abouzk/esp32-weld-motion-controller/README.md

# Automated Welding Workcell - Electromechanical Subsystem (Capstone)

**Role:** Electromechanical Subsystem Lead | **Platform:** ESP32 DevKit + DM542T Stepper Driver | **Actuator:** NEMA 23 (10:1 Gearbox) + Belt Drive Linear Actuator

**Context:** Senior Capstone Project — Automated Welding Theory Lab for undergraduate welding education at RPI.

---

## 1. Project Overview

This repository contains the embedded motion control firmware and electromechanical system architecture for an **automated weld travel system** that delivers consistent, repeatable weld beads for undergraduate metallurgical analysis.

The system replaces manual hand-welding (which introduces uncontrolled human variability in travel speed) with a deterministic linear actuator system, enabling students to isolate and study weld metallurgy rather than weld technique. My scope covers the electromechanical subsystem: drive analysis, speed derivation, microstepping configuration, state machine design, and motion control firmware.

Weld samples produced by the system undergo multi-stage analysis at the RPI Materials Research Center (MRC): macroetching, optical microscopy, and fillet weld break testing.

> **Full design rationale, trade studies, and speed derivations:** [Engineering Notebook Welding Log](https://github.com/abouzk/systems-engineering-notebook/blob/main/logs/esp32-weld-motion-controller-log.md)

---

## 2. Concept of Operations

The electromechanical subsystem occupies the **weld execution phase** of the broader lab workflow. From the operator's perspective:

```mermaid
flowchart LR
    A([Operator\nsets parameters]) --> B[System\nhomes to zero]
    B --> C[READY\nfor weld]
    C --> D[Operator\nstrikes arc]
    D --> E[Controlled travel\nat 6–8 IPM]
    E --> F[Target distance\nreached — HOLD]
    F --> G[Operator confirms\n→ RETRACT]
    G --> H([Sample to\nMRC analysis])

    style A fill:#ffb74d,stroke:#333,color:black
    style D fill:#ffb74d,stroke:#333,color:black
    style G fill:#ffb74d,stroke:#333,color:black
    style H fill:#81c784,stroke:#333,color:black
```

*Orange = operator action. Green = system output delivered to next lab phase.*

---

## 3. Electromechanical System Architecture

```mermaid
graph TD
    %% Define System Boundaries
    subgraph Human_Loop ["Human Interaction Layer"]
        Operator((Human Operator))
        GUI[PC/Laptop GUI]
        Pedal[Weld Trigger]
    end

    subgraph Logic ["Low-Voltage Logic (3.3V)"]
        ESP[ESP32 Microcontroller]
    end

    subgraph Power ["Power Distribution"]
        ESTOP((Physical E-STOP))
        ESTOP -- "Logic Signal (E-Stop Flag)" --> ESP
        PSU[24V Power Supply]
    end

    subgraph Drive ["High-Current Drive (24V)"]
        DM[DM542T Stepper Driver]
    end

    subgraph Physical ["Electromechanical Layer"]
        NEMA[NEMA23 Stepper Motor]
        Limit[Home Limit Switch]
        Welder[Weld Power Source]
        Gun[Weld Gun]
        Workpiece[Metal Workpiece]
    end

    %% Final Output
    Bead([Finished Weld Bead])

    %% Data and Logic Flow
    Operator -- "Inputs Parameters" --> GUI
    GUI -- "Serial/WiFi (G-Code)" --> ESP
    ESP -- "Step / Dir (3.3V)" --> DM
    Limit -- "Logic High/Low" --> ESP

    %% Power Flow & Hardware E-Stop (Direct Cut)
    ESTOP -- "Cuts 24V Circuit" --> PSU
    PSU -- "24V DC" --> DM
    DM -- "Switched Phase Currents" --> NEMA
    NEMA -- "Linear Translation" --> Gun

    %% Independent Weld Loop
    Operator -- "Physical Press" --> Pedal
    Pedal -- "Closes Circuit" --> Welder
    Welder -- "High Current Arc" --> Gun

    %% The Physical Output Generation
    Gun -- "Controlled Heat & Motion" --> Workpiece
    Workpiece -- "Yields" --> Bead

    %% Styling
    classDef human fill:#ffb74d,stroke:#333,stroke-width:2px,color:black;
    classDef output fill:#81c784,stroke:#333,stroke-width:2px,color:black;
    class Operator,GUI,Pedal human;
    class Bead output;
```

---

## 4. Embedded Control State Machine

```mermaid
stateDiagram-v2
    [*] --> STANDBY

    STANDBY --> HOMING : Start Cmd
    HOMING --> READY : Limit Switch Hit
    READY --> WELDING : Arc Strike / Begin Move
    WELDING --> HOLD : Target Distance Reached
    HOLD --> RETRACT : User Confirmation Input
    RETRACT --> STANDBY : Return to 0 Complete

    note right of WELDING
        E-STOP cuts 24V hardware circuit
        from any active state. Requires
        manual hardware reset to resume.
    end note
```

---

## 5. Driver Configuration

The actuator uses a NEMA 23 stepper with 10:1 gearbox and belt drive (pitch circumference = 72mm), requiring the motor to run at 21.2–28.2 RPM to achieve the 6–8 IPM target.

At full-step resolution (200 steps/rev), the minimum drive frequency of 70.7 Hz falls within the motor's primary mechanical resonance band, causing step loss and speed instability. Configured for 1/8 microstepping (1600 PPR) to shift the drive frequency to 565 Hz, producing smooth continuous motion across the full operational range.

| Parameter | Value |
|---|---|
| Microstepping | 1/8 (1600 PPR) |
| Drive freq range | 565–752 Hz (6–8 IPM) |
| STEP pin | GPIO 25 → PUL- |
| DIR pin | GPIO 26 → DIR- |
| ENA pin | GPIO 27 → ENA- |
| Limit switch | GPIO 32 (TBD -- two switches available, confirm before deployment) |
| E-STOP software pin | GPIO 33 (TBD) |

---

## 6. Hardware

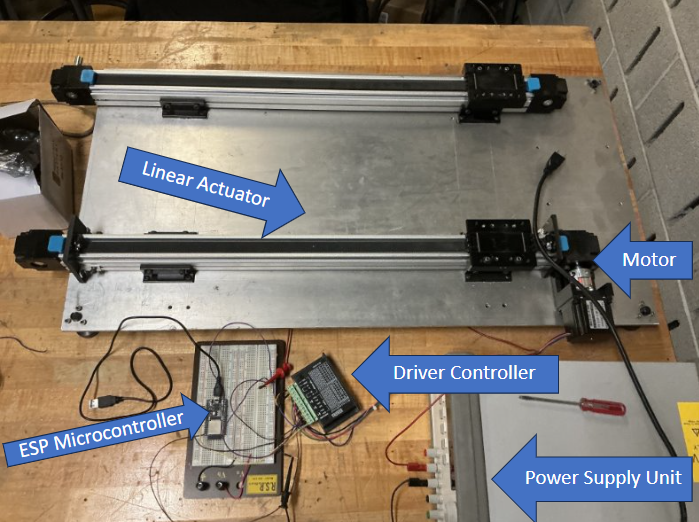
[picture p1: media/hardware_assembly_labeled.png]
Hardware assembly overview


*Phase 2 hardware assembly -- belt drive linear actuator, NEMA 23 motor,
DM542T stepper driver, ESP32 microcontroller, and 24V PSU.*

## 7. Hardware Safety Audit (March 18, 2026)

Physical inspection of the existing linear actuator assembly identified
a safety-critical finding prior to firmware deployment.

**Finding:** The home limit switch is mounted on a thin-walled plastic
U-bracket attached to the actuator end plate. Stress fracturing was
identified at the inner bracket corners under load. Bracket detachment
during operation would result in loss of home position reference with
no hardware stop signal -- the 30-second homing timeout in firmware
(`HOMING_TIMEOUT_US`) was implemented directly in response to this finding
as a software detection layer.

Risk assessed per **ISO 14971**. Hazard: bracket detachment. Risk classification: High. Control measures: firmware homing timeout (software detection) + bracket replacement (primary mitigation).

**Status:** Bracket replacement or reinforcement required before live
weld testing. Non-negotiable deployment gate.

| | |
|---|---|
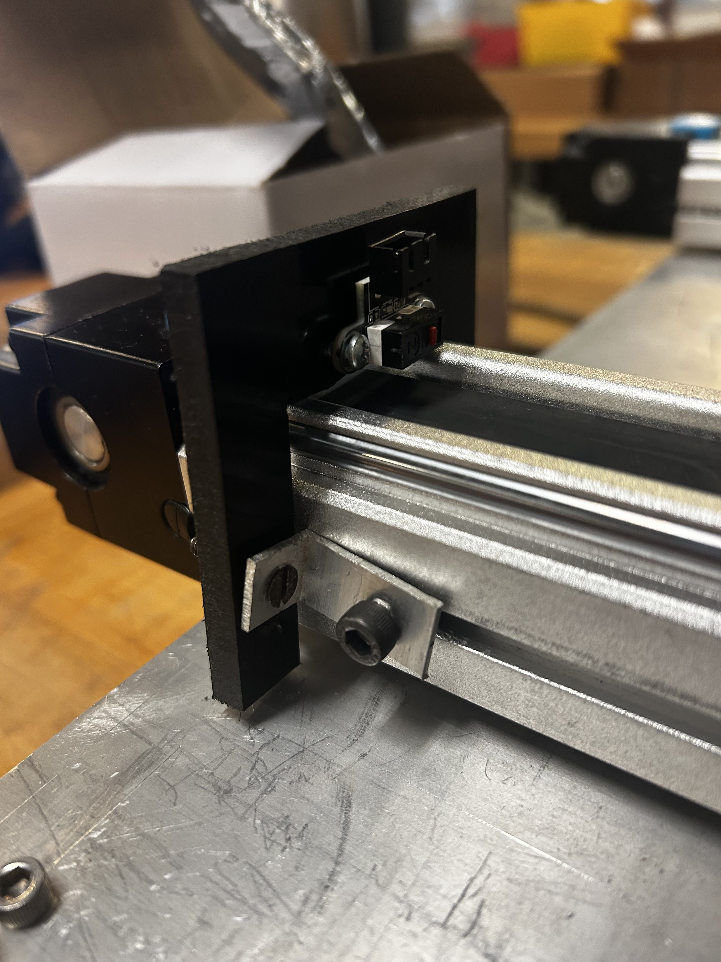
[picture p2: docs/audit/phase2_limit-switch-bracket-isometric_mar2026.jpg]
Bracket isometric
Bracket bird's eye
|  |  |
| *Limit switch bracket installed on actuator end* | *Bracket removed -- stress fracturing visible at inner corners* |

## 8. Repository Structure

```
esp32-weld-motion-controller/
├── src/
│   └── main.cpp                  # ESP32 motion control firmware
├── docs/
│   └── sketches/                 # Hand-drawn design artifacts (Phase 1)
|   └── audit/                    # Hardware safety audit photos (Phase 2)
├── media/
│   └── system_photo.jpg
└── README.md
```

## Phase definitions
Phase 1 -- paper design and requirements (Jan–Feb 2026)
Phase 2 -- physical hardware assembly and audit (Mar 2026)
Phase 3 -- firmware development and motion validation (active)

---

## 9. Engineering Retrospective

**Microstepping selection:** The 70.7 Hz → 565 Hz frequency shift from full-step to 1/8 microstep was the key configuration decision. At the required 21.2 RPM motor speed, full-step resonance would have been the dominant failure mode regardless of any other tuning.

**Future iteration:** Current velocity control is open-loop (fixed pulse frequency). A future revision would close the loop with encoder feedback on the actuator output shaft, compensating for load-dependent speed variation under variable weld gun drag forces.

---

## About

**Capstone Project** — Developed for the RPI MATL Department  
**My role:** Electromechanical subsystem lead — speed analysis, microstepping configuration, state machine design, motion control firmware  
**Collaborators:** GUI/frontend (teammate), wiring schematic (teammate)  
**Methodology:** ISO 14971, NASA Systems Engineering Handbook SP-2016-6105 Rev2
