abouzk/esp32-weld-motion-controller/docs/sketches/phase1_electrical-architecture-sketch_feb2026.pdf

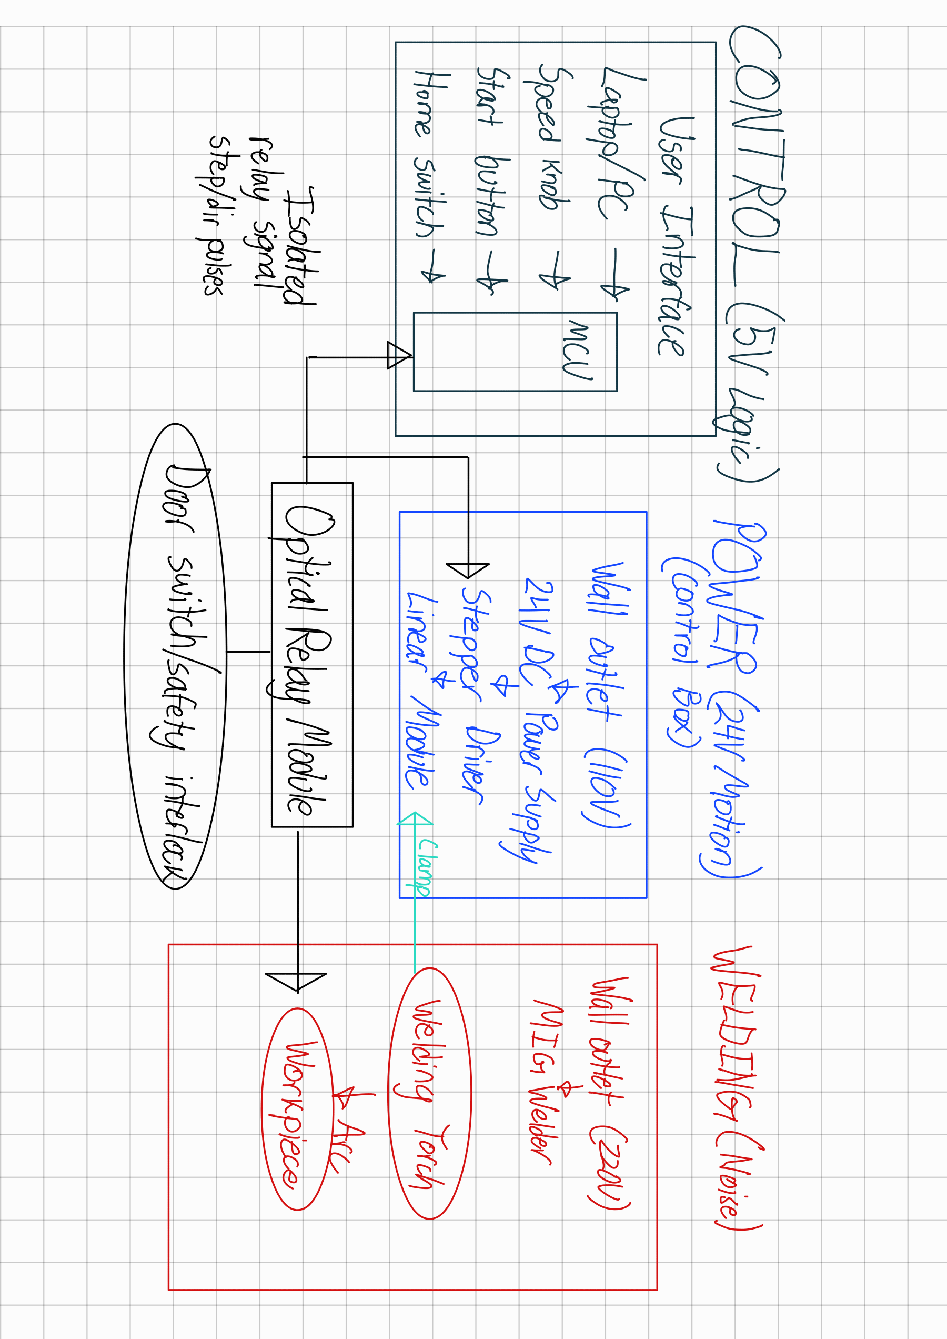
[picture p4: page 1]
