abouzk/esp32-weld-motion-controller/docs/audit/phase2_linear-actuator-side-view_mar2026.jpg

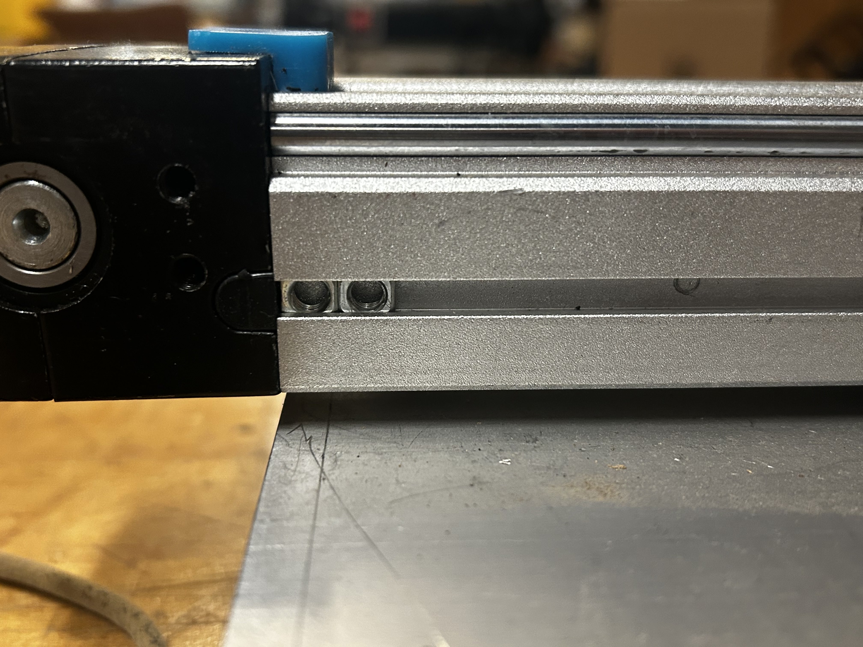
docs/audit/phase2_linear-actuator-side-view_mar2026.jpg
