abouzk/esp32-weld-motion-controller/docs/sketches/phase1_state-machine-sketch_feb2026.jpg

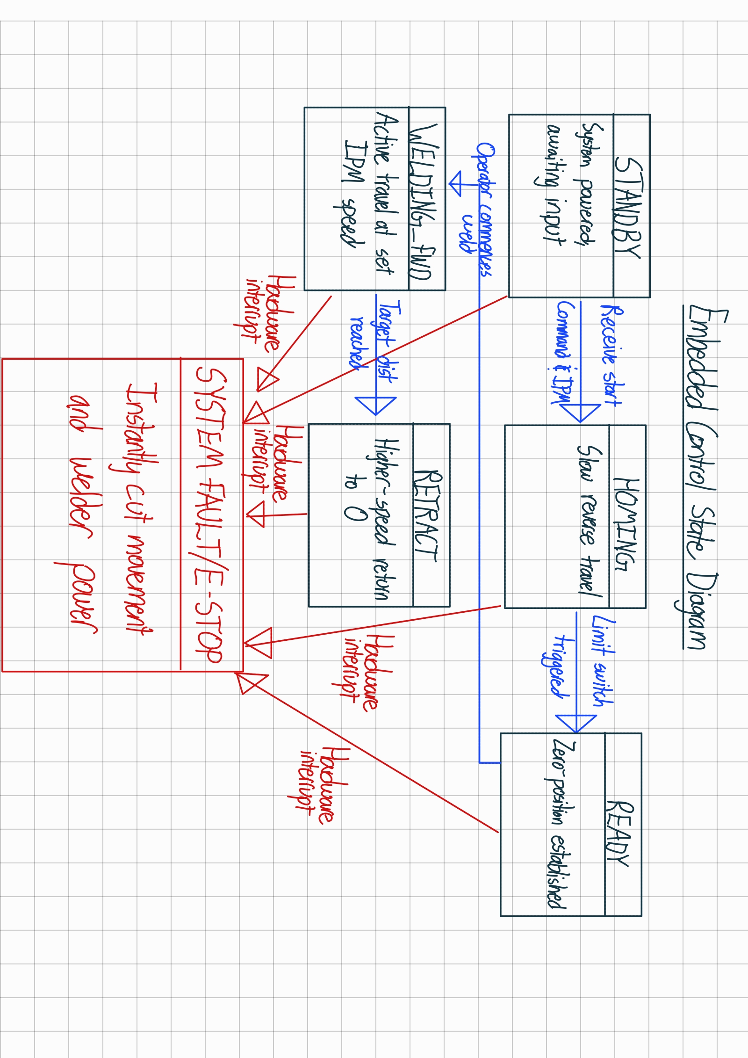
docs/sketches/phase1_state-machine-sketch_feb2026.jpg
