abouzk/esp32-weld-motion-controller/media/hardware_assembly.png

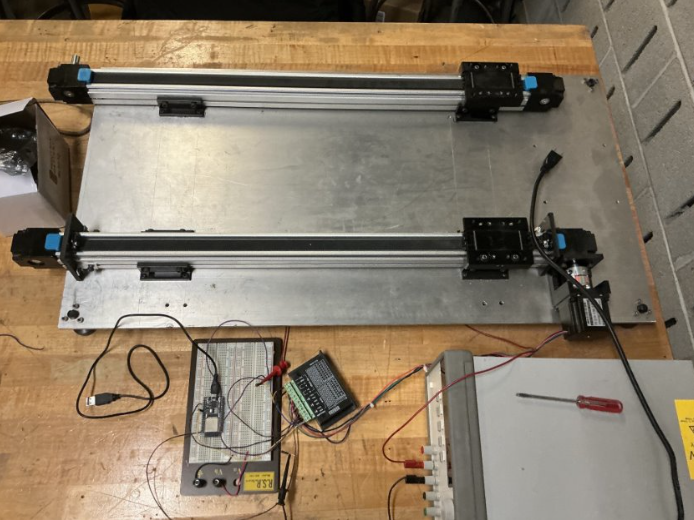
media/hardware_assembly.png
