abouzk/esp32-weld-motion-controller/(commit log)

2026-03-27 Revise README for automated welding workcell project
    Updated project title and provided detailed project overview, concept of operations, electromechanical system architecture, embedded control state machine, driver configuration, repository structure, and engineering retrospective.
2026-03-27 Revise README sections and add hardware overview
    Updated section headings and added hardware assembly overview.
2026-03-27 Update comments and welding speed in code
2026-03-27 Update GPIO pin assignments in README
