abouzk/esp32-weld-motion-controller/Plastic_Limit_Switch_Mounting_Frame_(Bird's_Eye_View).jpg

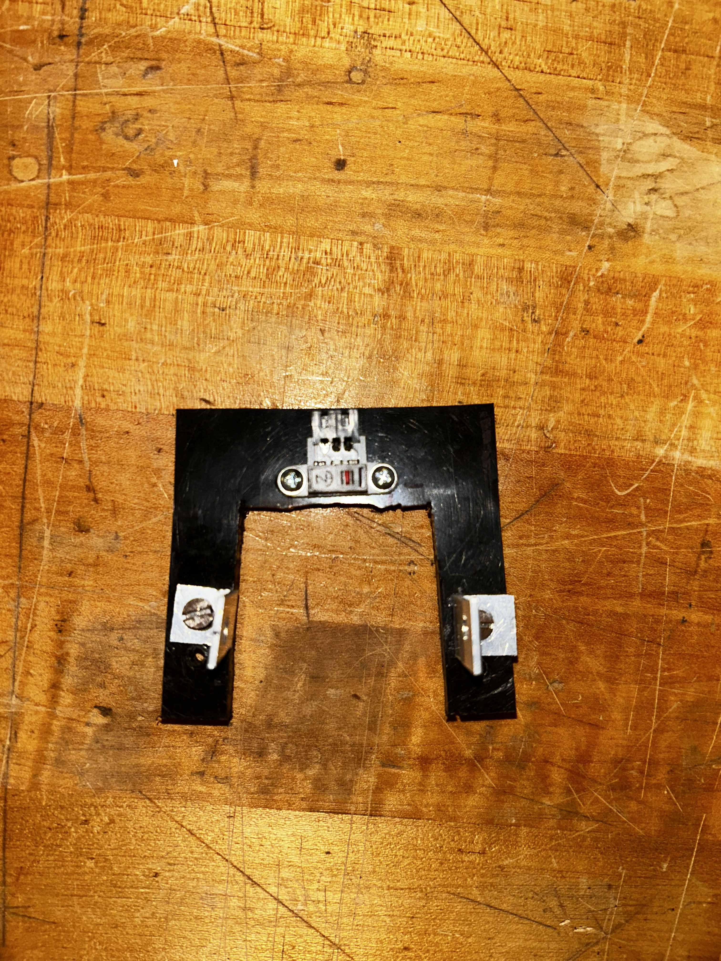
[picture p3: docs/audit/phase2_limit-switch-bracket-birds-eye_mar2026.jpg]
Plastic_Limit_Switch_Mounting_Frame_(Bird's_Eye_View).jpg
